killinen/BrakeModule/Pics/BM0.2.PNG

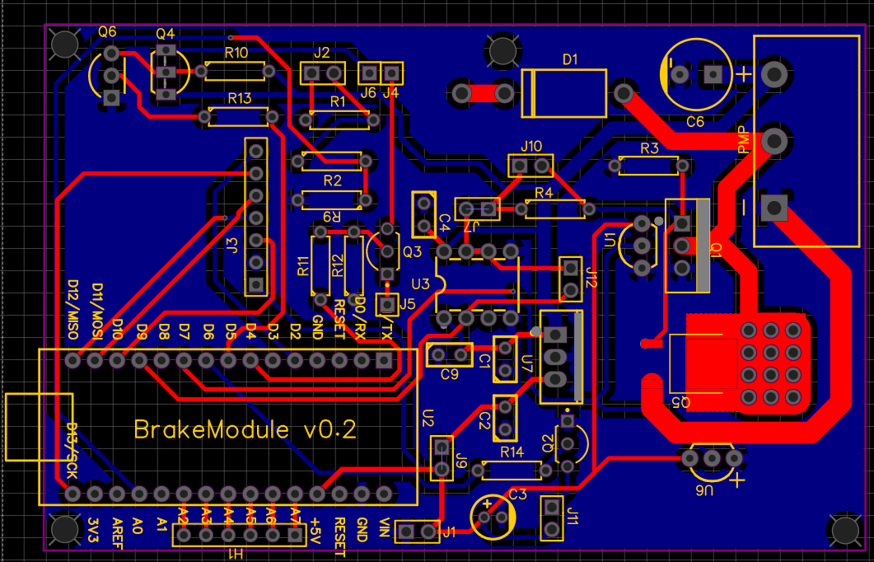
Pics/BM0.2.PNG
