killinen/BrakeModule/Pics/BM03.PNG

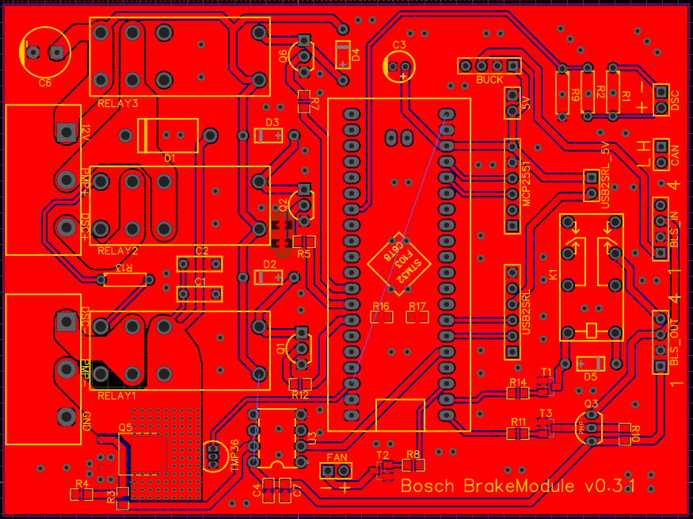
Pics/BM03.PNG
