killinen/BrakeModule/Pics/BM.jpg

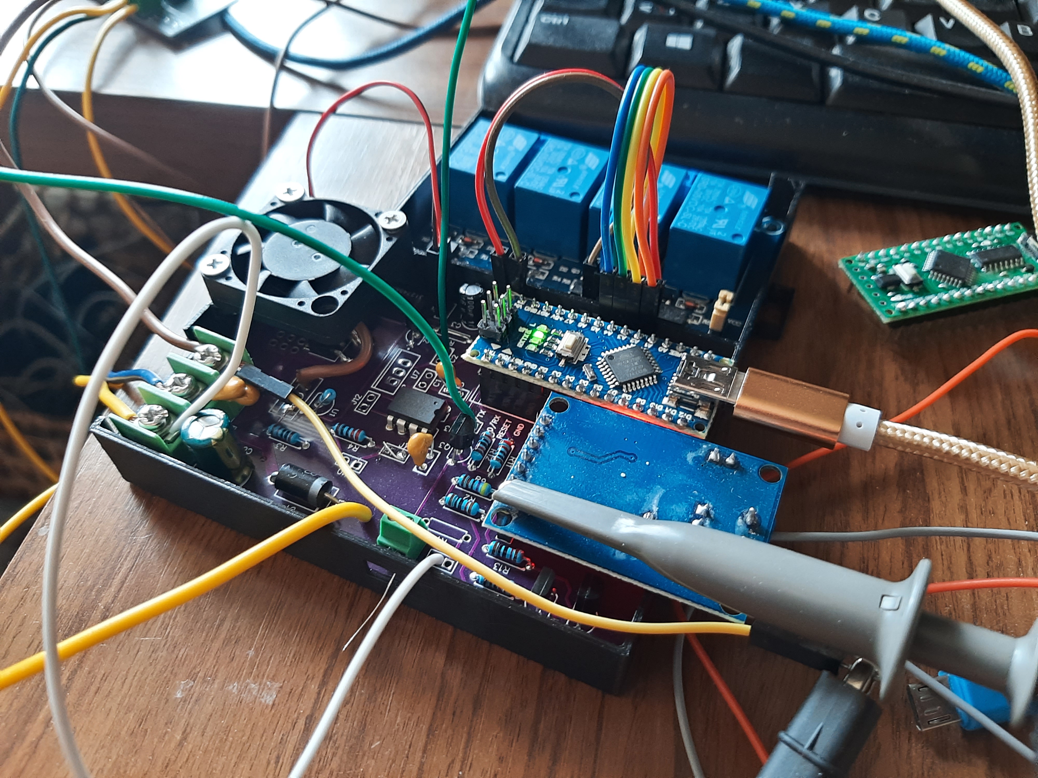
Pics/BM.jpg
