killinen/BrakeModule/Pics/Bosch57cars.PNG

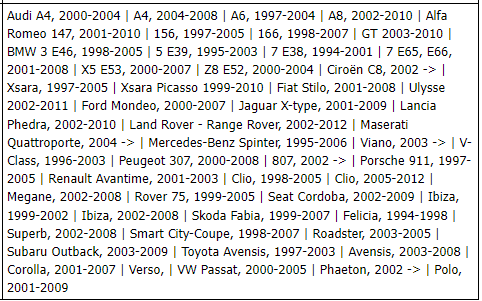
Pics/Bosch57cars.PNG
