killinen/BrakeModule/(threads)

Thread 1 (2022-05-05):

BMW CAN databases

dzid26, 2022-05-05:
https://github.com/killinen/BrakeModule#someone-might-think
As you mentioned another way would be to command DSC to the braking. If you have BMW's Dynamic Cruise Control (DCC - S540), then you could control the cruise speed setpoint rather easily via +/-  buttons messages. That's what [I do](https://github.com/dzid26/openpilot-for-BMW-E8x-E9x/blob/ab3a560bf0d0e678150bcfa9e20863807d4056f6/selfdrive/car/bmw/bmwcan.py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). Note, my BMW E82 1-series didn't have a dynamic cruise originally and I needed to [code it in](https://www.babybmw.net/forum/viewtopic.php?p=1061539#p1061539). After the coding DSC takes over cruise speed control and requests torque from DME and of course does the braking.
For the normal Cruise option (S540), the speed control was in the DME.
As to ACC option (S541) - I don't know what controls what. Perhaps this is the [clue](https://github.com/HeinrichG-V12/E65_ReverseEngineering/blob/main/docs/0x0B7.md).

Who knows - maybe these CAN databases could be similar to E39 and useful:
https://github.com/HeinrichG-V12/E65_ReverseEngineering
And mine: https://github.com/dzid26/opendbc-BMW-E8x-E9x

Of course, I know hacking the DSC module itself should be the more generic approach (if anyone will dare to reproduce).
